johnterickson/lutcomp/circuit/lcd_chars_b_w.png

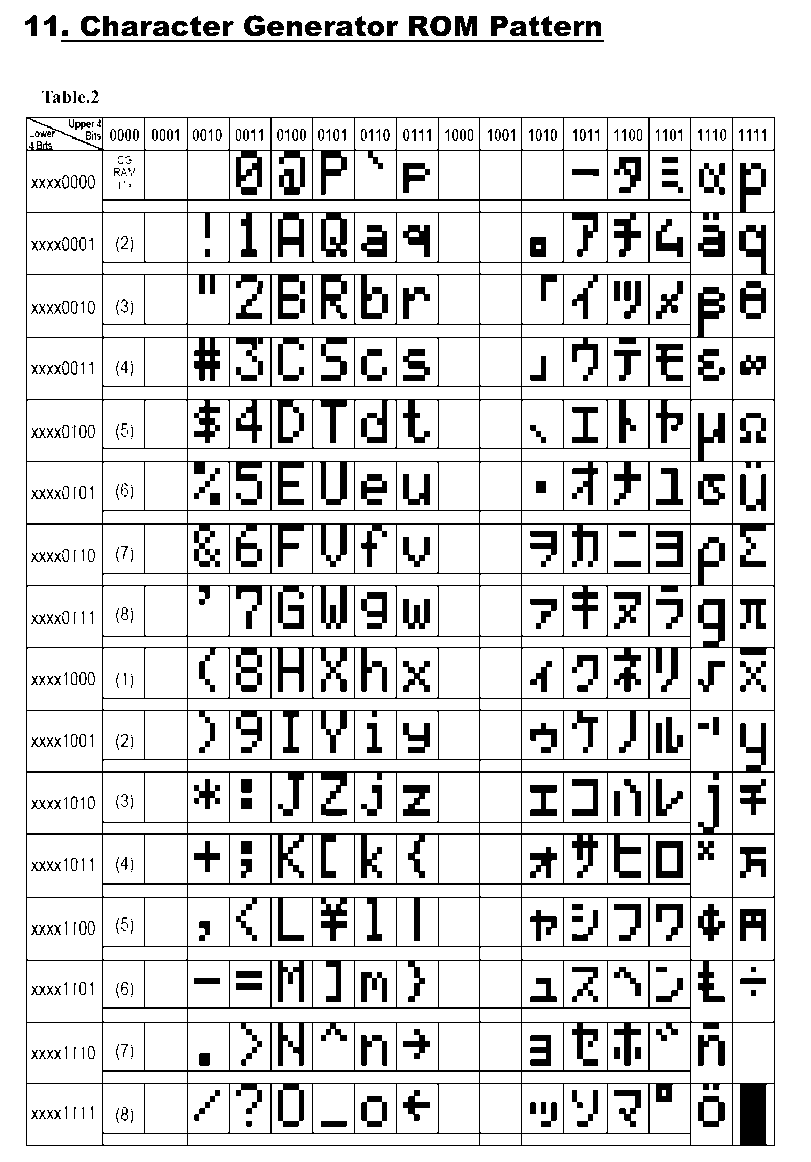
circuit/lcd_chars_b_w.png
