johnterickson/lutcomp/parts.txt

Note: 74LS and 74HC are incompatible - stick to LS & HCT

Registers:
----------

CD74HCT299E
Universal Shift Register 8-Bit 20-PDIP	
https://www.digikey.com/products/en?keywords=296-33146-5-ND%09
https://www.ti.com/lit/ds/symlink/cd74hc299.pdf?HQS=TI-null-null-digikeymode-df-pf-null-wwe&ts=1593966574726

SN74HCT377N
Flip Flop 1 Element D-Type 8 Bit Positive Edge 20-DIP (0.300", 7.62mm)
https://www.digikey.com/product-detail/en/texas-instruments/SN74HCT377N/296-8417-5-ND/376829
https://www.ti.com/general/docs/suppproductinfo.tsp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

CD74HCT374E
Flip Flop 1 Element D-Type 8 Bit Positive Edge 20-DIP (0.300", 7.62mm)	
https://www.digikey.com/product-detail/en/texas-instruments/CD74HCT374E/296-2115-5-ND/38536
https://www.ti.com/lit/ds/symlink/cd74hct374.pdf?HQS=TI-null-null-digikeymode-df-pf-null-wwe&ts=1593966859501

ROM:
----
SST39SF040-70-4C-PHE
FLASH Memory IC 4Mb (512K x 8) Parallel  70ns 32-PDIP
https://www.digikey.com/products/en?keywords=SST39SF040-70-4C-PHE
http://ww1.microchip.com/downloads/en/DeviceDoc/20005022C.pdf

RAM:
----
https://www.digikey.com/product-detail/en/alliance-memory-inc/AS6C4008-55PCN/1450-1027-ND/4234586
https://www.alliancememory.com/wp-content/uploads/pdf/AS6C4008.pdf

Decoder:
--------
CD74HCT138E
Decoder/Demultiplexer 1 x 3:8 16-PDIP
138N - selected is high - others are low https://www.digikey.com/en/products/detail/texas-instruments/CD74HCT138E/38262
238N - selected is low - others are high https://www.digikey.com/en/products/detail/texas-instruments/CD74HCT238E/38430

Adder:
------
CD74HCT283E
Binary Full Adder with Fast Carry IC 16-PDIP
https://www.digikey.com/product-detail/en/texas-instruments/CD74HCT283E/296-33143-5-ND/38488
https://www.ti.com/lit/ds/symlink/cd74hc283.pdf?HQS=TI-null-null-digikeymode-df-pf-null-wwe&ts=1593968382645

Counter:
--------
CD74HCT40103E
Counter IC Binary Counter 1 Element 8 Bit Positive Edge 16-PDIP
https://www.digikey.com/product-detail/en/texas-instruments/CD74HCT40103E/296-2159-5-ND/38561

SN74LS593N ($$$)
Counter IC Binary Counter 1 Element 8 Bit Positive Edge 20-PDIP
https://www.digikey.com/product-detail/en/texas-instruments/SN74LS593N/296-3719-5-ND/377750
also http://pdf.datasheetcatalog.com/datasheet/SGSThomsonMicroelectronics/mXtwrtw.pdf

https://www.digikey.com/en/products/detail/CD74HCT161E/296-2096-5-ND/38338?itemSeq=346381521 
https://www.ti.com/lit/ds/symlink/cd74hct163.pdf?HQS=TI-null-null-digikeymode-df-pf-null-wwe&ts=1606696934129

Inverter:
---------
SN74HCT14N
Inverter IC 6 Channel Schmitt Trigger 14-PDIP
https://www.digikey.com/product-detail/en/texas-instruments/SN74HCT14N/296-8394-5-ND/376852

4 channel x 2-input AND:
------------------------
SN74HCT08N‎
https://www.digikey.com/en/products/detail/SN74HCT08N/296-1606-5-ND/277252

LED segment:
------------
https://www.digikey.com/en/products/filter/leds-circuit-board-indicators-arrays-light-bars-bar-graphs/106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
e.g. https://www.digikey.com/en/products/detail/lite-on-inc/LTA-1000HR/153273

w/resistors https://www.digikey.com/en/products/detail/dialight/5555009F/2430761
