johnterickson/lutcomp/circuit/ps2spice/ps2spice.kicad_sch

## KiCad design circuit/ps2spice/ps2spice.kicad_sch (2022-09-04)

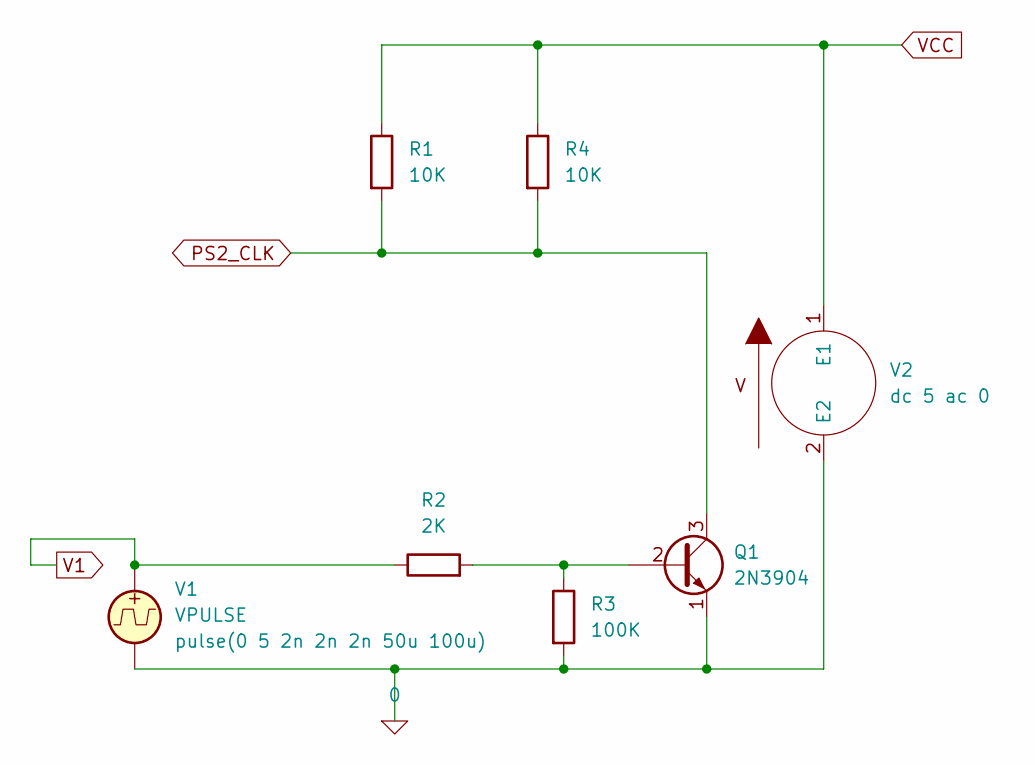
[picture p2: schematic ps2spice.kicad_sch]

Parts:
Q1: 2N3904; TO-92_Inline
R1, R4: 10K
R2: 2K
R3: 100K
V1: VPULSE
V2: dc 5 ac 0

Connections:
0: Q1.1 (E), R3.2, V1.2, V2.2 (E2)
unnamed: Q1.2 (B), R2.2, R3.1
PS2_CLK: Q1.3 (C), R1.2, R4.2
V1: R2.1, V1.1
VCC: R1.1, R4.1, V2.1 (E1)
