johnterickson/lutcomp/ghdl-rs/vpi_thunk.h

/* GHDL Run Time (GRT) - VPI thunks
   Copyright (C) 2003 - 2016 Tristan Gingold & Felix Bertram

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
   As a special exception, if other files instantiate generics from this
   unit, or you link this unit with other files to produce an executable,
   this unit does not by itself cause the resulting executable to be
   covered by the GNU General Public License. This exception does not
   however invalidate any other reasons why the executable file might be
   covered by the GNU Public License.
*/

/* VPI thunk is a GHDL structure used to interface between DLL/DSO and
   GRT.  This is in particular needed on Windows where undefined references
   in DLL are not supported.  */

#include "vpi_user.h"

typedef struct {
  vpiHandle  (*vpi_register_systf) (p_vpi_systf_data data);
  int        (*vpi_vprintf_no)     (char *fmt, void* ap);
  PLI_UINT32 (*vpi_mcd_close)      (PLI_UINT32 mcd);
  char*      (*vpi_mcd_name)       (PLI_UINT32 mcd);
  PLI_UINT32 (*vpi_mcd_open)       (char *name);
  PLI_UINT32 (*vpi_mcd_open_x)     (char *name, char *mode);
  int        (*vpi_mcd_vprintf_no) (PLI_UINT32 mcd, char *fmt, void* ap);
  int        (*vpi_mcd_fputc)      (PLI_UINT32 mcd, unsigned char x);
  int        (*vpi_mcd_fgetc)      (PLI_UINT32 mcd);
  vpiHandle  (*vpi_register_cb)    (p_cb_data data);
  int        (*vpi_remove_cb)      (vpiHandle ref);
  void       (*vpi_sim_vcontrol_no)(int operation, void* ap);
  vpiHandle  (*vpi_handle)         (int type, vpiHandle ref);
  vpiHandle  (*vpi_iterate)        (int type, vpiHandle ref);
  vpiHandle  (*vpi_scan)           (vpiHandle iter);
  vpiHandle  (*vpi_handle_by_index)(vpiHandle ref, int index);
  void       (*vpi_get_time)       (vpiHandle obj, s_vpi_time*t);
  int        (*vpi_get)            (int property, vpiHandle ref);
  char*      (*vpi_get_str)        (int property, vpiHandle ref);
  void       (*vpi_get_value)      (vpiHandle expr, p_vpi_value value);
  vpiHandle  (*vpi_put_value)      (vpiHandle obj, p_vpi_value value,
				      p_vpi_time when, int flags);
  int        (*vpi_free_object)    (vpiHandle ref);
  int        (*vpi_get_vlog_info)  (p_vpi_vlog_info vlog_info_p);
  int        (*vpi_chk_error)      (p_vpi_error_info info);
  vpiHandle  (*vpi_handle_by_name) (char *name, vpiHandle scope);
  int        (*vpi_control_np)     (int op, int status);
} vpi_thunk, *p_vpi_thunk;
