johnterickson/lutcomp/(commit log)

2020-06-17 switch to single byte instructions
    [lutcomp.circ]
2020-06-17 loops and terminates
    [lutcomp.circ]
2020-06-18 parsing argh
    [lutcomp.circ]
2020-06-18 16 bit add
    [lutcomp.circ]
2020-06-21 tty works after first byte
    [echochar.circ]
2020-06-21 echochar shows working stdin/stdout
    [echochar.circ]
2020-06-21 echo works on lut!
    [lutcomp.circ]
2020-06-21 seperate keyboard and its controller
    [lutcomp.circ]
2020-06-21 cleanup MMU
    [lutcomp.circ]
2020-06-21 more cleanup
    [lutcomp.circ]
2020-06-23 begin 4x6
    [echochar.circ, lutcomp.circ]
2020-06-23 flip name ordering
    [echochar.circ, lutcomp.circ]
2020-06-23 progress on 6x4
    [echochar.circ, lutcomp.circ]
2020-06-27 more tinkering
    [lutcomp.circ]
2020-06-27 start with 16-bit instructions
    [lutcomp.circ]
2020-06-28 6x4 hi
    [lutcomp.circ]
2020-06-29 labels and printing hex
2020-07-08 ucode for control lines
    [lutcomp.circ]
2020-07-11 packed_struct bug?
    [lutcomp.circ]
2020-07-13 need to figure out how to write to tty not - not RAM
    [lutcomp.circ]
2020-07-14 PC load from bus is broken
    [lutcomp.circ]
2020-07-14 halt and loading pc works
    [lutcomp.circ]
2020-07-15 echo works
    [lutcomp.circ]
2020-07-16 working with 74138
    [lutcomp.circ]
2020-07-16 remove tmp register
    [lutcomp.circ]
2020-07-18 16-bit uCode
    [lutcomp.circ]
2020-07-18 checkpoint in restructuring
    [lutcomp.circ]
2020-07-19 i like where this is going
    [lutcomp.circ]
2020-07-21 add works!
    [lutcomp.circ]
2020-07-22 fetch to reg
    [lutcomp.circ]
2020-07-23 micro-op is zero-extended
    [lutcomp.circ]
2020-07-26 mul8 works in logisim
    [lutcomp.circ]
2020-07-27 single instruction add32; start work on assembler and compiler
2020-07-29 echo works!
    [lutcomp.circ]
2020-07-29 fancy echo
    [lutcomp.circ]
2020-08-01 prepare assembler for compiler
2020-08-02 more tests and fixes
    [main.rs]
2020-12-01 first hardware order
    [lutcomp.circ]
2020-12-01 use a cheaper chip
    [lutcomp.circ]
2020-12-18 match more physical parts
    [lutcomp.circ]
2020-12-18 more hardware
    [lutcomp.circ]
2020-12-19 fix names
    [lutcomp.circ]
2020-12-19 add arduino controller
2020-12-27 compiler progress
    [lutcomp.circ]
2020-12-27 print hex function
2021-01-13 fix base vs dynamic stack offset
    [main.rs]
2021-01-20 move to private packed_struct with sign bit extension fix
    [lib.rs]
2021-02-01 fixed bugs to get strstr to work
    [lib.rs, main.rs]
2021-08-29 Add test program to build
    [lutcomp.circ]
2021-12-06 removing one-stage compiler
2021-12-06 more removal and cleanup; fix assembly optimization
2021-12-09 test HW sim with latest ucode and compiler
    [lutcomp.circ]
2021-12-10 special case frame pointer; add divide to ALU
2021-12-11 fix build scripts and asm
    [main.rs]
2022-07-06 refreshed circ
    [lutcomp.circ]
2022-07-16 add helper to update logisim file
    [lutcomp.circ]
2022-07-16 use consistent xml ordering
    [lutcomp.circ]
2022-07-18 logisim is busted??
    [lutcomp.circ]
2022-07-18 carry lookahead
    [lutcomp.circ]
2022-07-19 confirmed that rpn works in logisim
    [lutcomp.circ]
2022-07-20 improved logisim perf
    [lutcomp.circ]
2022-07-21 optimizations before LOHI
    [lutcomp.circ]
2022-07-23 free up ALU slot by AddLoNoCarry and AddLoCarry
    [lutcomp.circ]
2022-07-30 ALU Mul8_16
    [lutcomp.circ]
2022-07-30 split Mul8 into Mul8_8 and Mul8_32
    [lutcomp.circ]
2022-07-30 mul8_32 to mul8_16
    [lutcomp.circ]
2022-07-30 e2e u16
    [lutcomp.circ]
2022-07-31 intrinsic e2e
    [lutcomp.circ]
2022-08-08 some inlining is working
    [lutcomp.circ]
2022-08-08 more inlining
    [lutcomp.circ]
2022-08-09 inline in topo sort order
    [lutcomp.circ]
2022-08-09 fix based on flamegraph
    [lib.rs]
2022-08-18 prep for ram tests
    [lutcomp.circ]
2022-08-18 some RAM
    [lutcomp.circ]
2022-08-18 tested in HW
    [lutcomp.circ]
2022-08-19 more deterministic
    [lutcomp.circ]
2022-08-25 strip unreferenced functions
    [lutcomp.circ]
2022-08-26 add some inline
    [lutcomp.circ]
2022-08-27 assembled but not working
2022-08-27 Echo works in Digital
    [lutcomp.circ]
2022-08-29 fixed sign-extend to zero extend
    [lutcomp.circ]
2022-09-03 break out test circuit
2022-09-04 add buffer to ps2 decoder so LED can show pending value
2022-09-04 remove last remnants of logisim
    [lutcomp.circ]
2022-09-04 ps2 SPICE simulator
    [ps2spice.kicad_pcb, ps2spice.kicad_sch]
2022-09-07 interrupt checkpoint
2022-09-07 add some interrupt circuitry
2022-09-09 interrupt intrinsics
2022-09-09 protect multi opcode instructions from interrupts
2022-09-15 wait for circuit to settle before typing
2022-09-23 allow multiple operations without reseting CS
    [AC780S.vhdl]
2022-09-25 fix build - I hope
    [lib.rs]
2022-09-25 tty and ps2 interrupt tests
2022-10-01 abstract simulated devices
2022-10-27 fix infinite recursion in lcd
    [lib.rs]
2022-11-05 some const prop
2023-09-29 turn on wifi and restore clock speed now that power rails are better connected
